TheCacophonyProject/bird-monitor-pcb/bird-monitor-power-solar/bird-monitor-power-solar.kicad_pcb

## KiCad design bird-monitor-power-solar/bird-monitor-power-solar.kicad_pcb (2023-08-14)

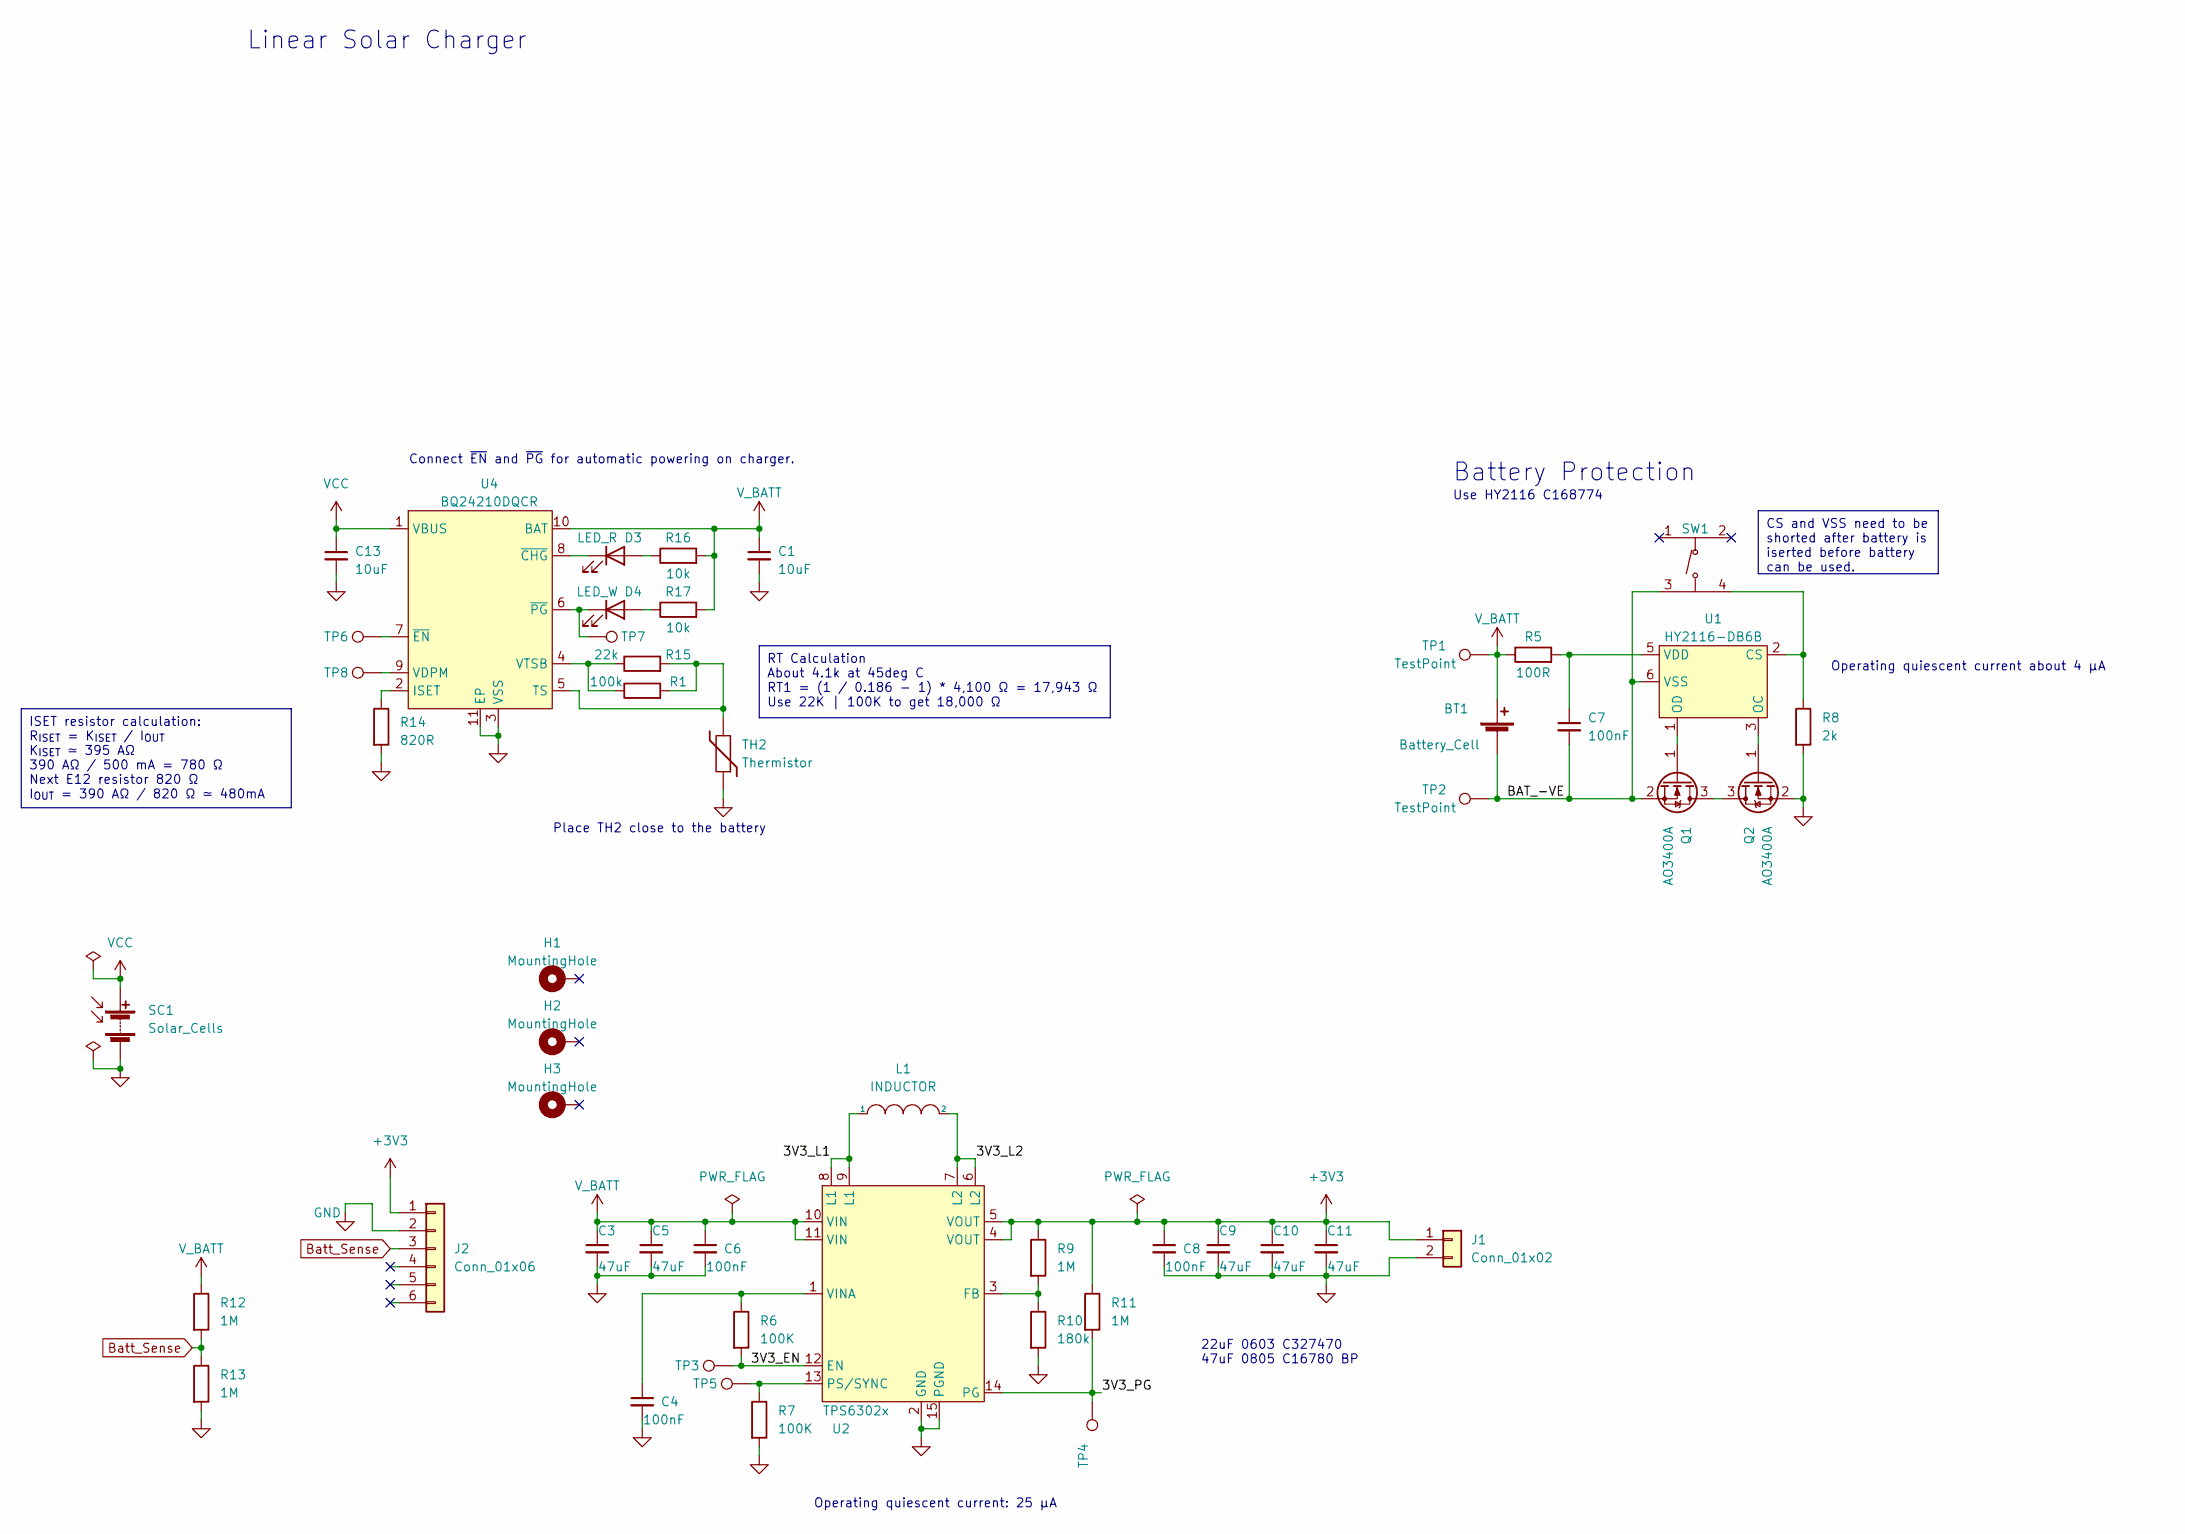
[picture p1: schematic bird-monitor-power-solar.kicad_sch]

Parts:
BT1: Battery_Cell; 18650_holder; LCSC C5290176
C1, C13: 10uF; C_0603_1608Metric; LCSC C96446
C3, C5, C9, C10, C11: 47uF; C_0805_2012Metric; LCSC C16780
C4, C6, C7, C8: 100nF; C_0402_1005Metric; LCSC C307331
D3: LED_R; LED_0603_1608Metric; LCSC C2286
D4: LED_W; LED_0603_1608Metric; LCSC C2290
H1, H2, H3: MountingHole; MountingHole_3.2mm_M3_DIN965_Pad
J1: Conn_01x02; PinHeader_1x02_P2.54mm_Vertical
J2: Conn_01x06; PinHeader_1x06_P2.54mm_Vertical
L1: INDUCTOR; IND-SMD_L6.6-W6.6_MCW-06XX; LCSC C169313
Q1, Q2: AO3400A; SOT-23; LCSC C20917
R1: 100k; R_0402_1005Metric; LCSC C25741
R5: 100R; R_0402_1005Metric; LCSC C25076
R6, R7: 100K; R_0402_1005Metric; LCSC C25741
R8: 2k; R_0603_1608Metric; LCSC C22975
R9, R11: 1M; R_0402_1005Metric; LCSC C26083
R10: 180k; R_0402_1005Metric; LCSC C409856
R12, R13: 1M; R_0603_1608Metric; LCSC C22935
R14: 820R; R_0603_1608Metric; LCSC C23253
R15: 22k; R_0402_1005Metric; LCSC C25768
R16, R17: 10k; R_0402_1005Metric; LCSC C25744
SC1: Solar_Cells; PinHeader_1x02_P2.54mm_Vertical
SW1: TS-1187A-B-A-B; SW-SMD_4P-L5.1-W5.1-P3.70-LS6.5-TL-2; LCSC Part C318884
TH2: Thermistor; R_0805_2012Metric; LCSC C95968
TP1, TP2, TP3, TP4, TP5, TP6, TP7, TP8: TestPoint; TestPoint_THTPad_D2.0mm_Drill1.0mm
U1: HY2116-DB6B; SOT-23-6; LCSC C168774
U2: TPS6302x; VSON-14_L4.0-W3.0-P0.50-BL-EP_TI_DSJ; LCSC C15483
U4: BQ24210DQCR; WSON-10-1EP_2x3mm_P0.5mm_EP0.84x2.4mm; LCSC Part C524795

Connections:
+3V3: C8.1, C9.1, C10.1, C11.1, J1.1, J2.1, R9.1, R11.1, U2.4 (VOUT), U2.5 (VOUT)
/3V3_EN: R6.2, TP3.1, U2.12 (EN)
/3V3_L1: L1.1, U2.8 (L1), U2.9 (L1)
/3V3_L2: L1.2, U2.6 (L2), U2.7 (L2)
/3V3_PG: R11.2, TP4.1, U2.14 (PG)
/BAT_-VE: BT1.2 (-), C7.2, Q1.2 (S), SW1.3, TP2.1, U1.6 (VSS)
Batt_Sense: J2.3, R12.2, R13.1
GND: C1.2, C3.2, C4.2, C5.2, C6.2, C8.2, C9.2, C10.2, C11.2, C13.2, J1.2, J2.2, Q2.2 (S), R7.2, R8.2, R10.2, R13.2, R14.2, SC1.2 (-), TH2.1, U2.2 (GND), U2.15 (PGND), U4.3 (VSS), U4.11 (EP)
unnamed: D3.2 (A), R16.1
unnamed: D3.1 (K), U4.8 (~CHG)
unnamed: D4.2 (A), R17.1
unnamed: D4.1 (K), TP7.1, U4.6 (~PG)
unnamed: Q1.3 (D), Q2.3 (D)
unnamed: Q1.1 (G), U1.1 (OD)
unnamed: Q2.1 (G), U1.3 (OC)
unnamed: R8.1, SW1.4, U1.2 (CS)
unnamed: C7.1, R5.2, U1.5 (VDD)
unnamed: R9.2, R10.1, U2.3 (FB)
unnamed: R7.1, TP5.1, U2.13 (PS/SYNC)
unnamed: C4.1, R6.1, U2.1 (VINA)
unnamed: R14.1, U4.2 (ISET)
unnamed: R1.2, R15.2, TH2.2, U4.5 (TS)
unnamed: TP8.1, U4.9 (VDPM)
unnamed: R1.1, R15.1, U4.4 (VTSB)
unnamed: TP6.1, U4.7 (~EN)
VCC: C13.1, SC1.1 (+), U4.1 (VBUS)
V_BATT: BT1.1 (+), C1.1, C3.1, C5.1, C6.1, R5.1, R12.1, R16.2, R17.2, TP1.1, U2.10 (VIN), U2.11 (VIN), U4.10 (BAT)

Notes on the sheet:
RT Calculation About 4.1k at 45deg C RT1 = (1 / 0.186 - 1) * 4,100 Ω = 17,943 Ω Use 22K | 100K to get 18,000 Ω
CS and VSS need to be shorted after battery is iserted before battery can be used.
ISET resistor calculation: R_{ISET} = K_{ISET} / I_{OUT} K_{ISET} ≃ 395 AΩ 390 AΩ / 500 mA = 780 Ω Next E12 resistor 820 Ω I_{OUT} = 390 AΩ / 820 Ω ≃ 480mA
Operating quiescent current about 4 μA
Battery Protection
Connect ~{EN} and ~{PG} for automatic powering on charger.
Use HY2116 C168774
Operating quiescent current: 25 μA
Place TH2 close to the battery
Linear Solar Charger
22uF 0603 C327470 47uF 0805 C16780 BP

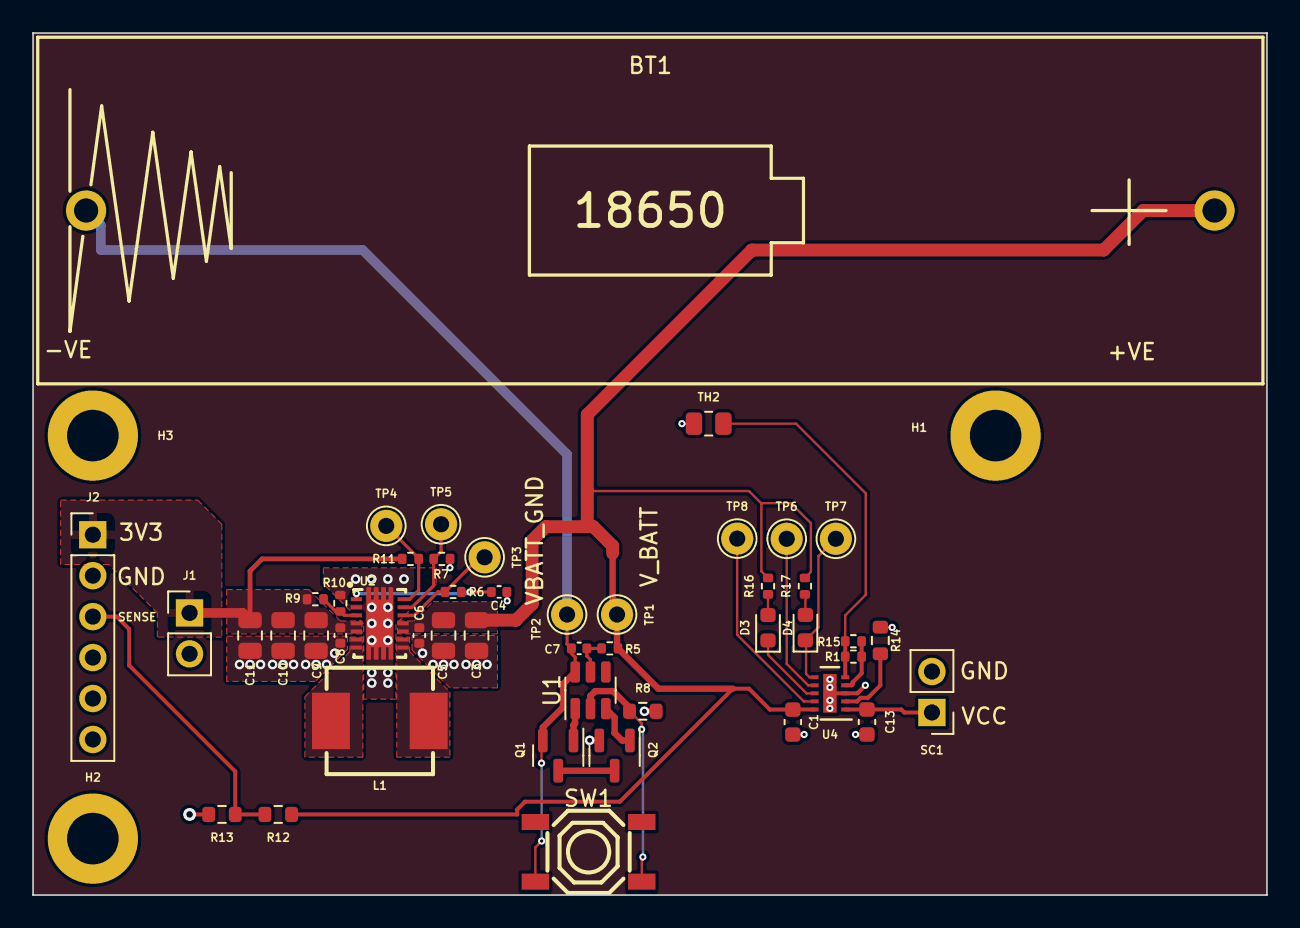
[picture p2: board bird-monitor-power-solar.kicad_pcb from above]

Board: 4 copper layers, 76.5 x 53.5 mm, 50 parts (0 on the bottom side), 27 nets.
