TheCacophonyProject/bird-monitor-pcb/bird-monitor-main/bird-monitor.kicad_pcb

## KiCad design bird-monitor-main/bird-monitor.kicad_pcb (2023-08-14)

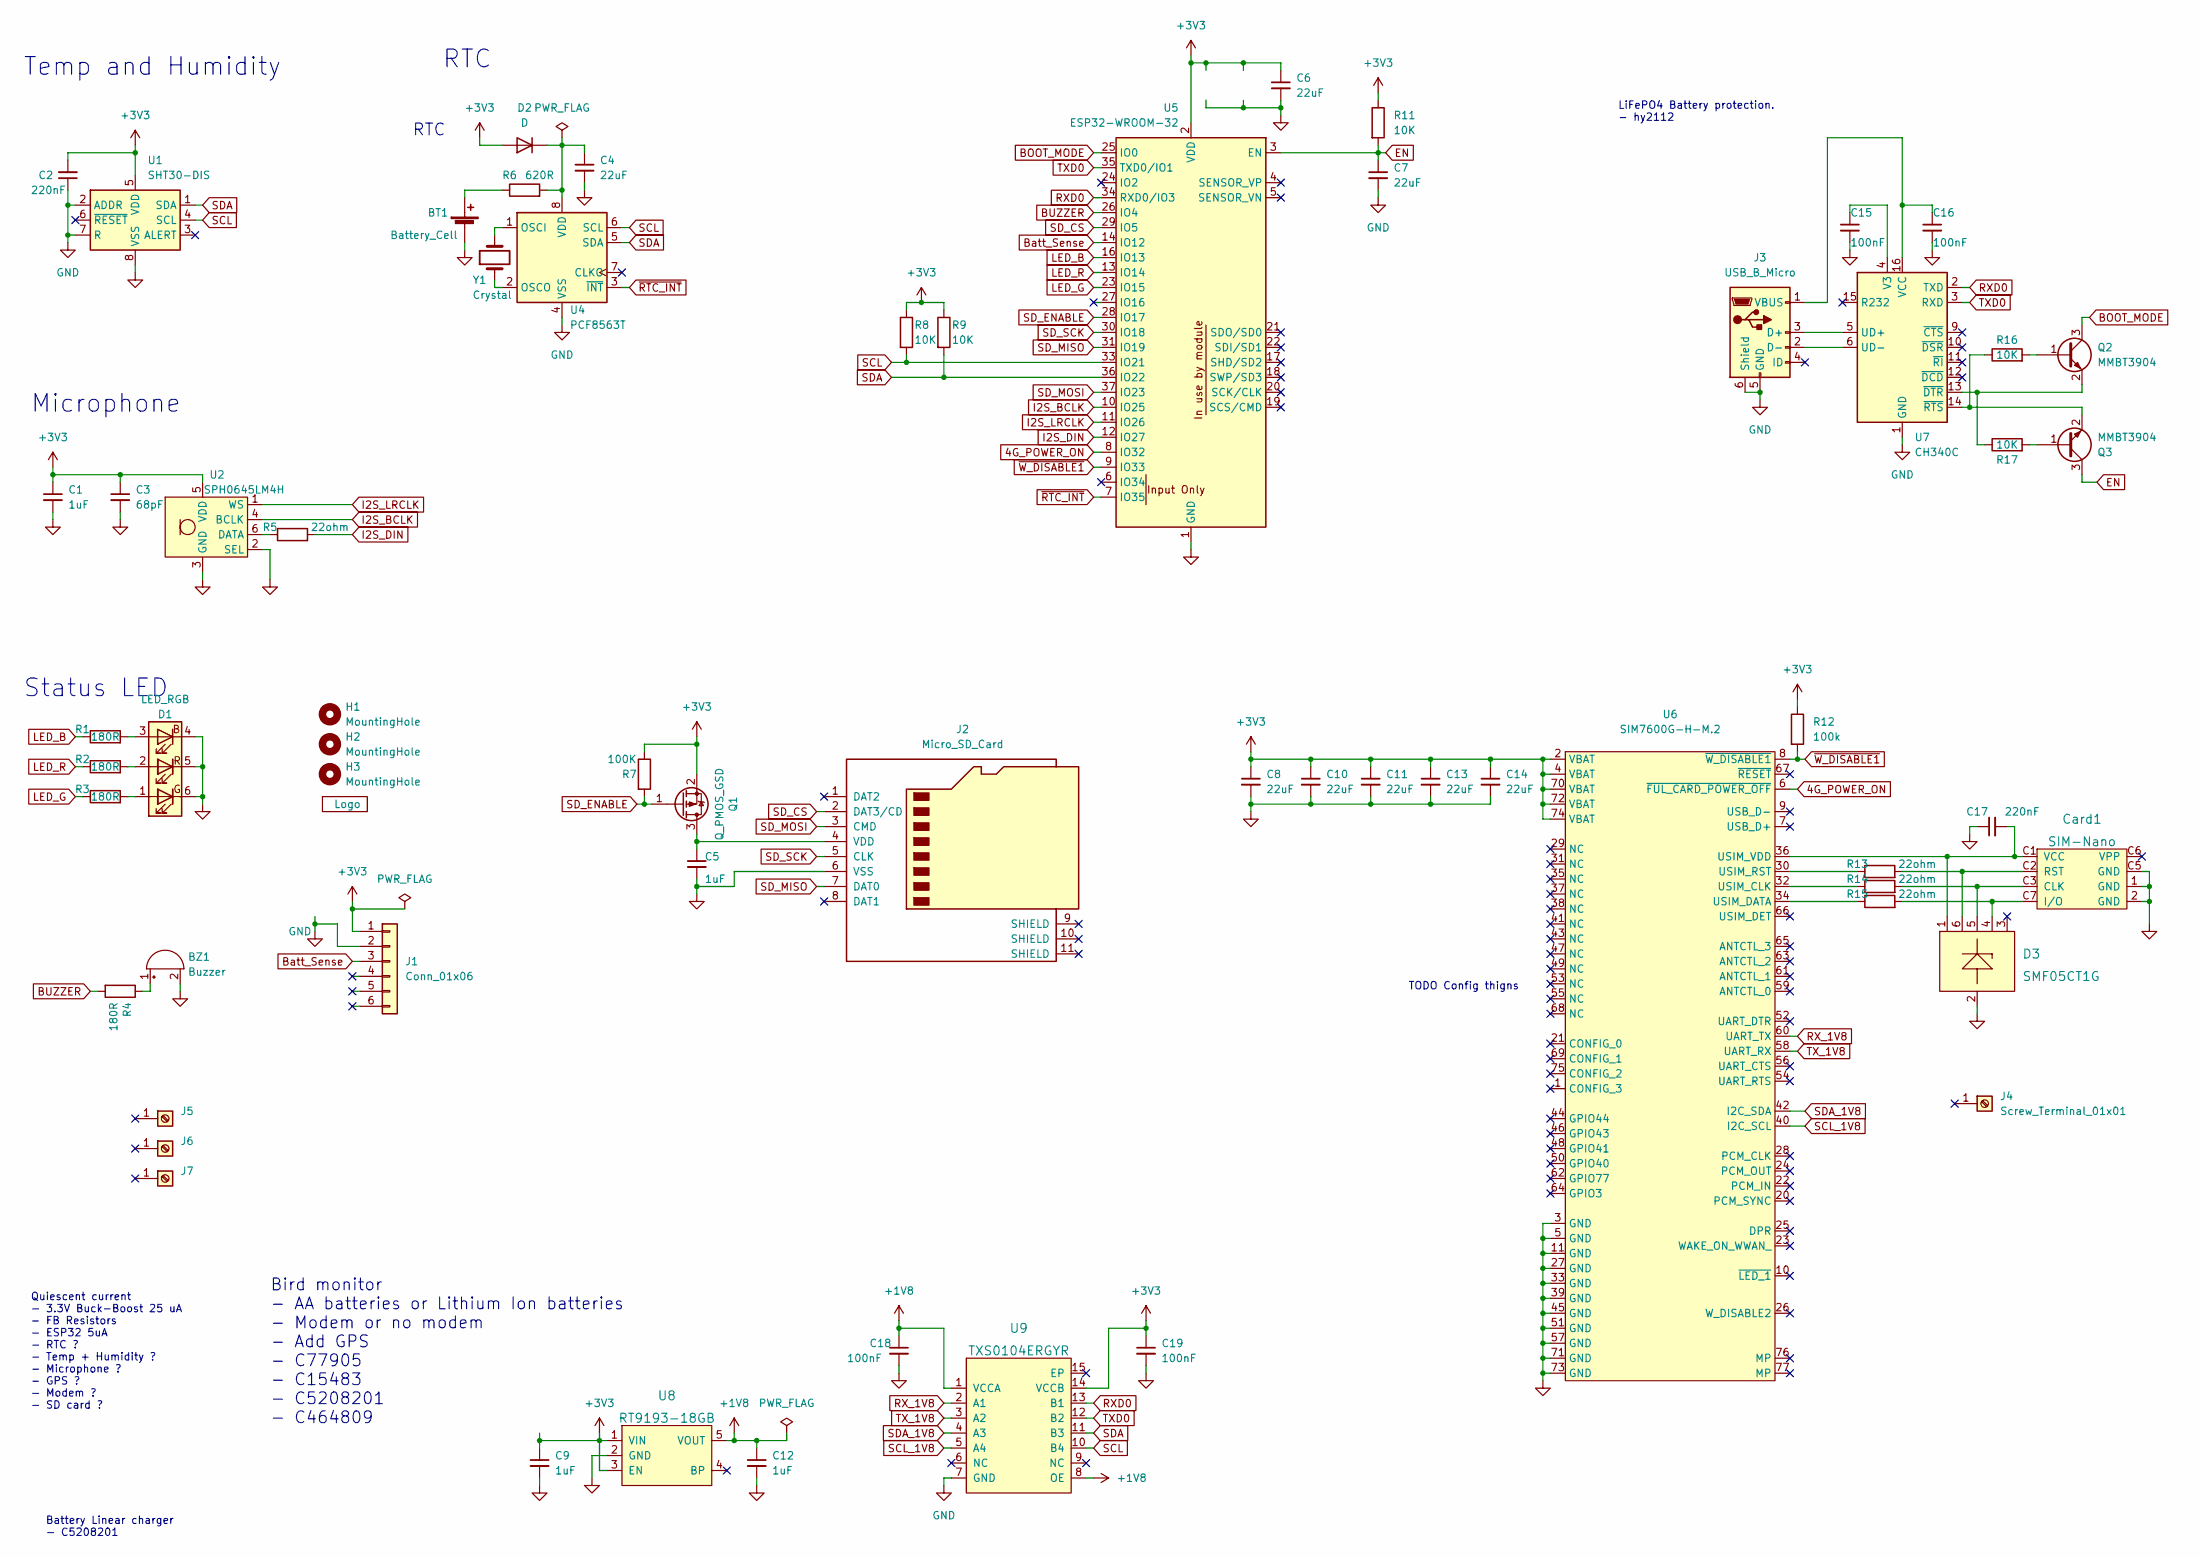
[picture p3: schematic bird-monitor.kicad_sch]

Parts:
BT1: Battery_Cell; CAP-SMD_FL11E
BZ1: Buzzer; BUZ-TH_BD9.0-P5.00-D0.6-FD; LCSC C96102
C1, C5, C9, C12: 1uF; C_0402_1005Metric; LCSC C52923
C2, C17: 220nF; C_0402_1005Metric; LCSC C16772
C3: 68pF; C_0402_1005Metric; LCSC C14441
C4, C6, C7, C8, C10, C11, C13, C14: 22uF; C_0603_1608Metric; LCSC C59461
C15, C16, C18, C19: 100nF; C_0402_1005Metric; LCSC C307331
Card1: SIM-Nano; LCSC C266889
D1: LED_RGB; LCSC C375568
D2: D; D_SOD-123F; LCSC C64898
D3: SMF05CT1G; SOT-363_L2.0-W1.3-P0.65-LS2.1-TL; LCSC C15879
H1, H2, H3: MountingHole; MountingHole_3.2mm_M3_DIN965_Pad
J1: Conn_01x06; PinHeader_1x06_P2.54mm_Vertical
J2: Micro_SD_Card; SD_Micro; LCSC C393941
J3: USB_B_Micro; 920-E52A2021S10100; LCSC C10418
J4: Screw_Terminal_01x01; SMD_M2_nut; LCSC C2928176
J5, J6, J7: Screw_Terminal_M2_L10; SMD_NUT_D5.6-HD3.6-L10.0; LCSC C2928171
Q1: Q_PMOS_GSD; SOT-23; LCSC C15127
Q2, Q3: MMBT3904; SOT-23; LCSC C20526
R1, R2, R3, R4: 180R; R_0603_1608Metric; LCSC C22828
R5, R13, R14, R15: 22ohm; R_0402_1005Metric; LCSC C25092
R6: 620R; R_0603_1608Metric; LCSC C23220
R7: 100K; R_0402_1005Metric; LCSC C25741
R8, R9, R11, R16, R17: 10K; R_0402_1005Metric; LCSC C25744
R12: 100k; R_0402_1005Metric; LCSC C25741
U1: SHT30-DIS; Sensirion_DFN-8-1EP_2.5x2.5mm_P0.5mm_EP1.1x1.7mm; LCSC C77361
U2: SPH0645LM4H; MIC_SPH0645LM4H-B; LCSC C2686054
U3: Logo; logo
U4: PCF8563T; SOIC-8_3.9x4.9mm_P1.27mm; LCSC C7440
U5: ESP32-WROOM-32; LCSC C701341
U6: SIM7600G-H-M.2; M.2; LCSC C2761526
U7: CH340C; SOIC-16_3.9x9.9mm_P1.27mm; LCSC C84681
U8: RT9193-18GB; SOT-23-5; LCSC C27416
U9: TXS0104ERGYR; VQFN-14_L3.5-W3.5-P0.50-BL-EP; LCSC Part C154926
Y1: Crystal; Crystal_SMD_3215-2Pin_3.2x1.5mm; LCSC C32346

Connections:
4G_POWER_ON: U5.8 (IO32), U6.6 (~FUL_CARD_POWER_OFF)
+1V8: C12.1, C18.1, U8.5 (VOUT), U9.1 (VCCA), U9.8 (OE)
+3V3: C1.1, C2.2, C3.1, C6.1, C8.1, C9.1, C10.1, C11.1, C13.1, C14.1, C19.1, D2.2 (A), J1.1, Q1.2 (S), R7.1, R8.1, R9.1, R11.1, R12.1, U1.5 (VDD), U2.5 (VDD), U5.2 (VDD), U6.2 (VBAT), U6.4 (VBAT), U6.70 (VBAT), U6.72 (VBAT), U6.74 (VBAT), U8.1 (VIN), U8.3 (EN), U9.14 (VCCB)
BOOT_MODE: Q2.3 (C), U5.25 (IO0)
BUZZER: R4.2, U5.26 (IO4)
Batt_Sense: J1.3, U5.14 (IO12)
EN: C7.1, Q3.3 (C), R11.2, U5.3 (EN)
GND: BT1.2 (-), BZ1.2 (+), C1.2, C2.1, C3.2, C4.2, C5.2, C6.2, C7.2, C8.2, C9.2, C10.2, C11.2, C12.2, C13.2, C14.2, C15.2, C16.2, C17.1, C18.2, C19.2, Card1.1 (GND), Card1.2 (GND), Card1.C5 (GND), D1.4 (BK), D1.5 (GK), D1.6 (RK), D3.2, J1.2, J2.6 (VSS), J3.5 (GND), J3.6 (Shield), U1.2 (ADDR), U1.7 (R), U1.8 (VSS), U1.9 (VSS), U2.2 (SEL), U2.3 (GND), U4.4 (VSS), U5.1 (GND), U5.15 (GND), U5.38 (GND), U5.39 (GND), U6.3 (GND), U6.5 (GND), U6.11 (GND), U6.27 (GND), U6.33 (GND), U6.39 (GND), U6.45 (GND), U6.51 (GND), U6.57 (GND), U6.71 (GND), U6.73 (GND), U7.1 (GND), U8.2 (GND), U9.7 (GND)
I2S_BCLK: U2.4 (BCLK), U5.10 (IO25)
I2S_DIN: R5.2, U5.12 (IO27)
I2S_LRCLK: U2.1 (WS), U5.11 (IO26)
LED_B: R1.1, U5.16 (IO13)
LED_G: R3.1, U5.23 (IO15)
LED_R: R2.1, U5.13 (IO14)
unnamed: BT1.1 (+), R6.1
unnamed: BZ1.1 (-), R4.1
unnamed: C4.1, D2.1 (K), R6.2, U4.8 (VDD)
unnamed: C5.1, J2.4 (VDD), Q1.3 (D)
unnamed: C15.1, U7.4 (V3)
unnamed: C16.1, J3.1 (VBUS), U7.16 (VCC)
unnamed: C17.2, Card1.C1 (VCC), D3.1, U6.36 (USIM_VDD)
unnamed: Card1.C2 (RST), D3.6, R13.2
unnamed: Card1.C3 (CLK), D3.5, R14.2
unnamed: Card1.C7 (I/O), D3.4, R15.2
unnamed: D1.1 (RA), R3.2
unnamed: D1.2 (GA), R2.2
unnamed: D1.3 (BA), R1.2
unnamed: J3.2 (D-), U7.6 (UD-)
unnamed: J3.3 (D+), U7.5 (UD+)
unnamed: Q2.1 (B), R16.2
unnamed: Q2.2 (E), R17.1, U7.13 (~DTR)
unnamed: Q3.1 (B), R17.2
unnamed: Q3.2 (E), R16.1, U7.14 (~RTS)
unnamed: R5.1, U2.6 (DATA)
unnamed: R13.1, U6.30 (USIM_RST)
unnamed: R14.1, U6.32 (USIM_CLK)
unnamed: R15.1, U6.34 (USIM_DATA)
unnamed: U4.1 (OSCI), Y1.2
unnamed: U4.2 (OSCO), Y1.1
RXD0: U5.34 (RXD0/IO3), U7.2 (TXD), U9.13 (B1)
RX_1V8: U6.60 (UART_TX), U9.2 (A1)
SCL: R8.2, U1.4 (SCL), U4.6 (SCL), U5.33 (IO21), U9.10 (B4)
SCL_1V8: U6.40 (I2C_SCL), U9.5 (A4)
SDA: R9.2, U1.1 (SDA), U4.5 (SDA), U5.36 (IO22), U9.11 (B3)
SDA_1V8: U6.42 (I2C_SDA), U9.4 (A3)
SD_CS: J2.2 (DAT3/CD), U5.29 (IO5)
SD_ENABLE: Q1.1 (G), R7.2, U5.28 (IO17)
SD_MISO: J2.7 (DAT0), U5.31 (IO19)
SD_MOSI: J2.3 (CMD), U5.37 (IO23)
SD_SCK: J2.5 (CLK), U5.30 (IO18)
TXD0: U5.35 (TXD0/IO1), U7.3 (RXD), U9.12 (B2)
TX_1V8: U6.58 (UART_RX), U9.3 (A2)
~RTC_INT: U4.3 (~INT), U5.7 (IO35)
~W_DISABLE1: R12.2, U5.9 (IO33), U6.8 (~W_DISABLE1)

Notes on the sheet:
Temp and Humidity
Battery Linear charger - C5208201
TODO Config thigns
RTC
Quiescent current - 3.3V Buck-Boost 25 uA - FB Resistors - ESP32 5uA - RTC ? - Temp + Humidity ? - Microphone ? - GPS ? - Modem ? - SD card ?
Status LED
Microphone
Bird monitor - AA batteries or Lithium Ion batteries - Modem or no modem - Add GPS - C77905 - C15483 - C5208201 - C464809
LiFePO4 Battery protection. - hy2112

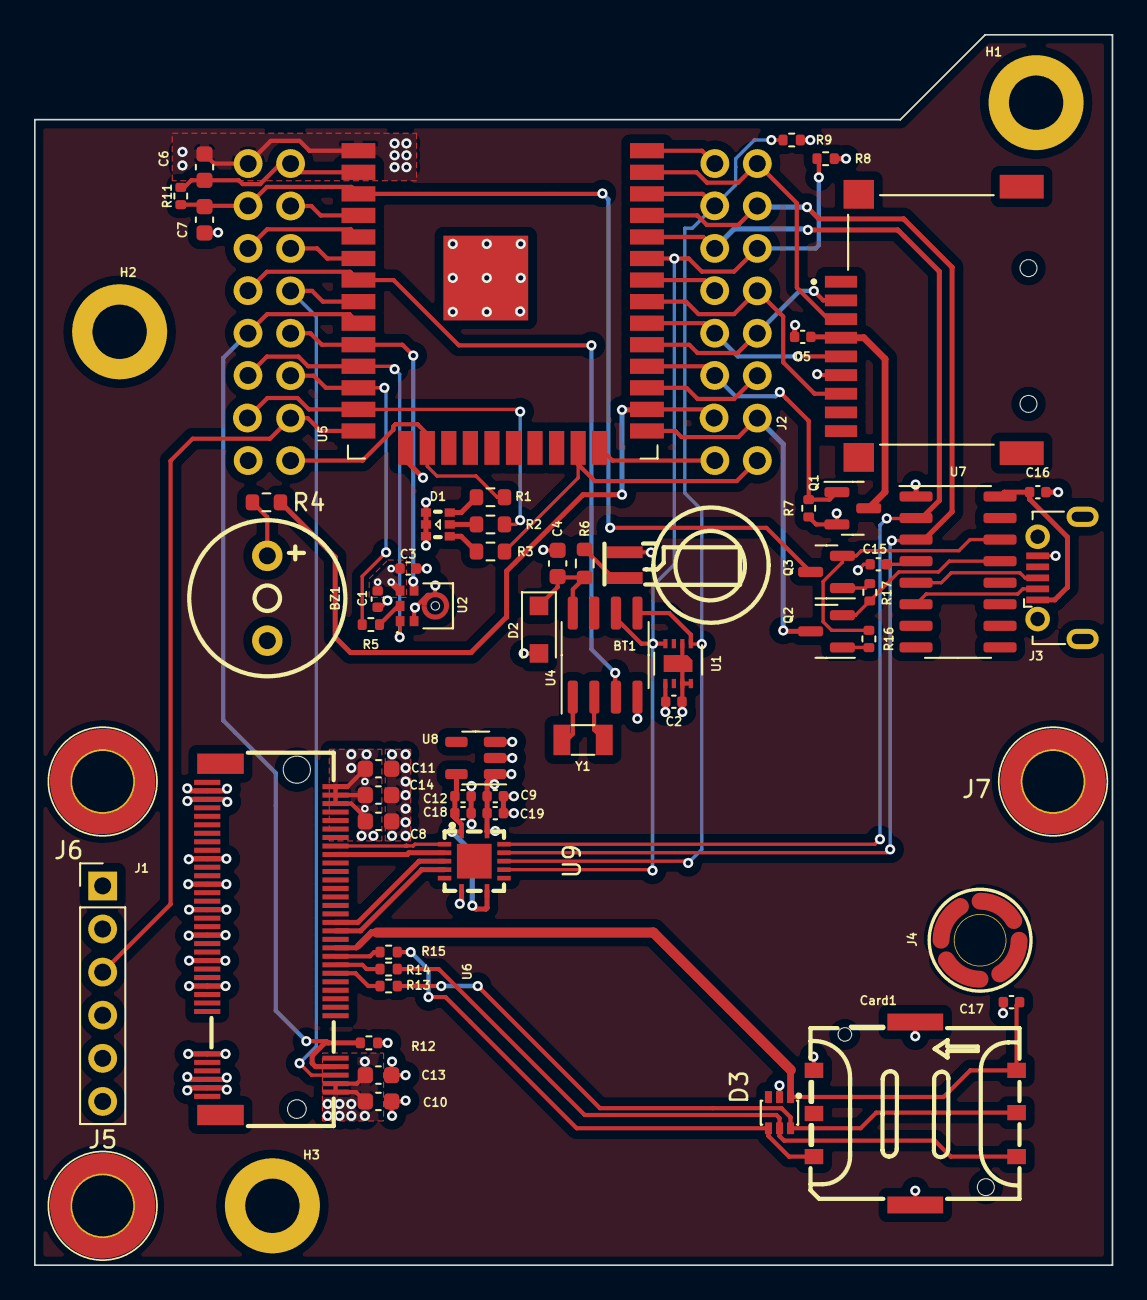
[picture p4: board bird-monitor.kicad_pcb from above]

Board: 4 copper layers, 63.5 x 72.5 mm, 64 parts (1 on the bottom side), 54 nets.
